AnandKapadia/Mobot_ACE/mobot2.jpg

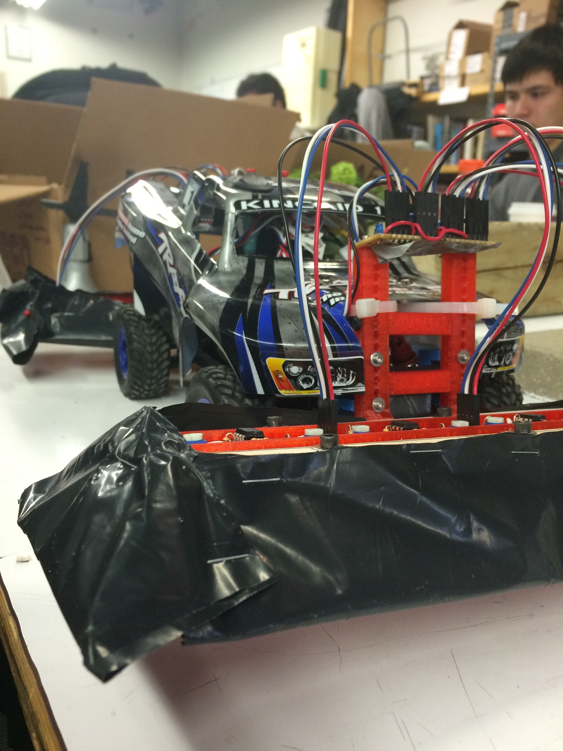
mobot2.jpg
