AnandKapadia/Mobot_ACE/mobot1.jpg

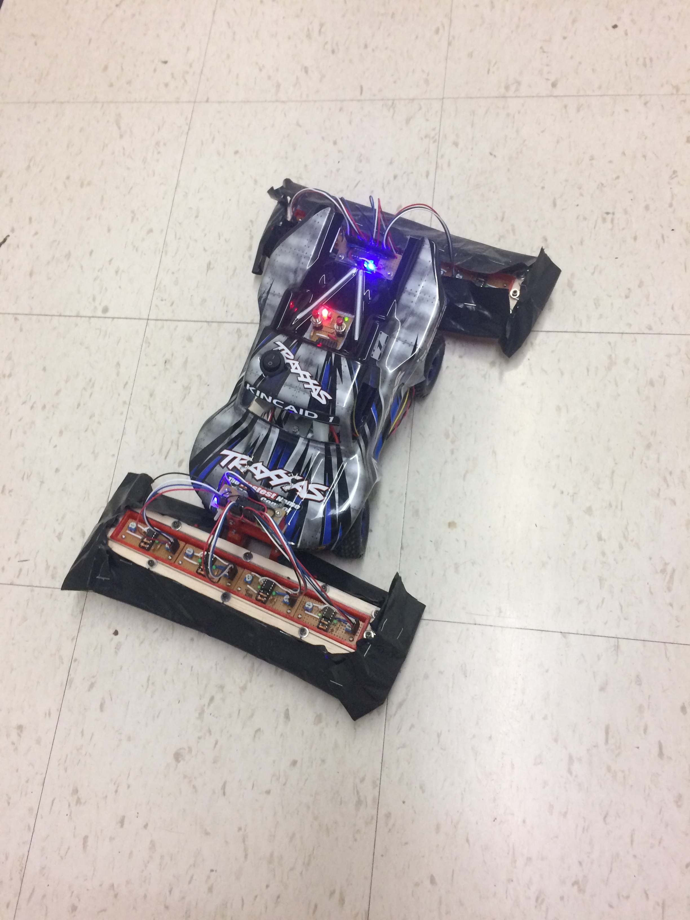
mobot1.jpg
