AnandKapadia/Mobot_ACE/documentation/arduino/mobot_arduinoPins.jpg

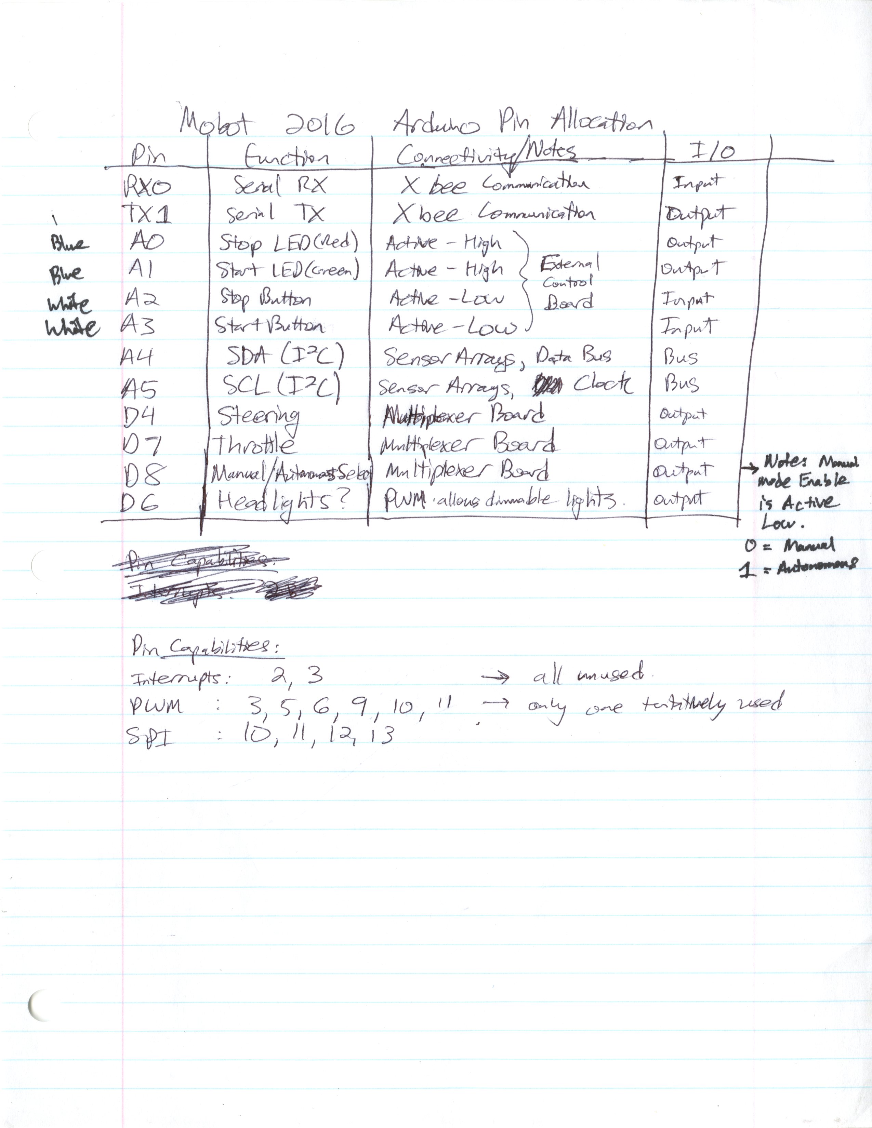
documentation/arduino/mobot_arduinoPins.jpg
