AnandKapadia/Mobot_ACE/documentation/control/mobot_controlPanelLayout.jpg

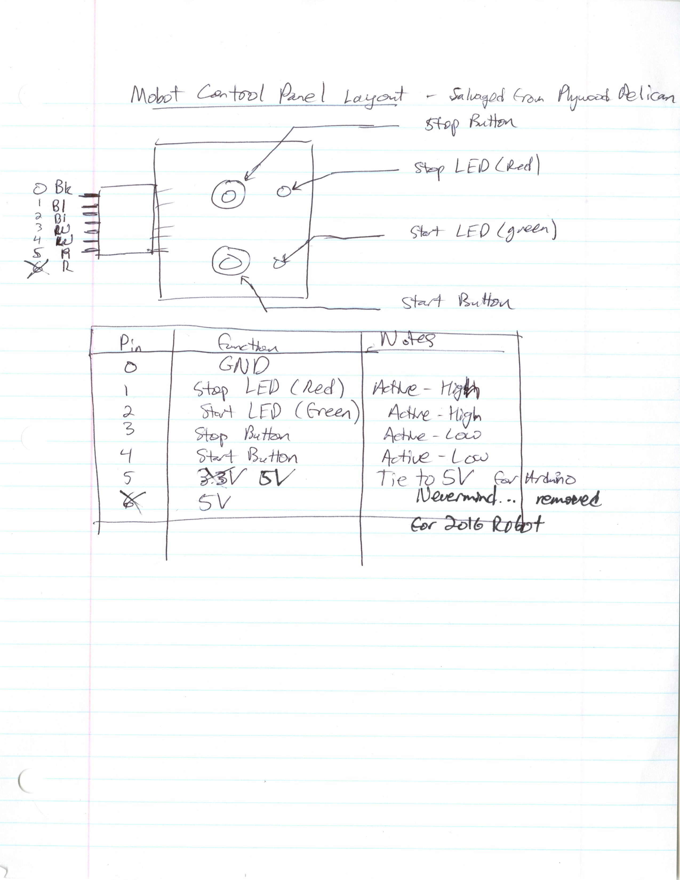
documentation/control/mobot_controlPanelLayout.jpg
