AnandKapadia/Mobot_ACE/documentation/control/mobot_finalControlSystem.jpg

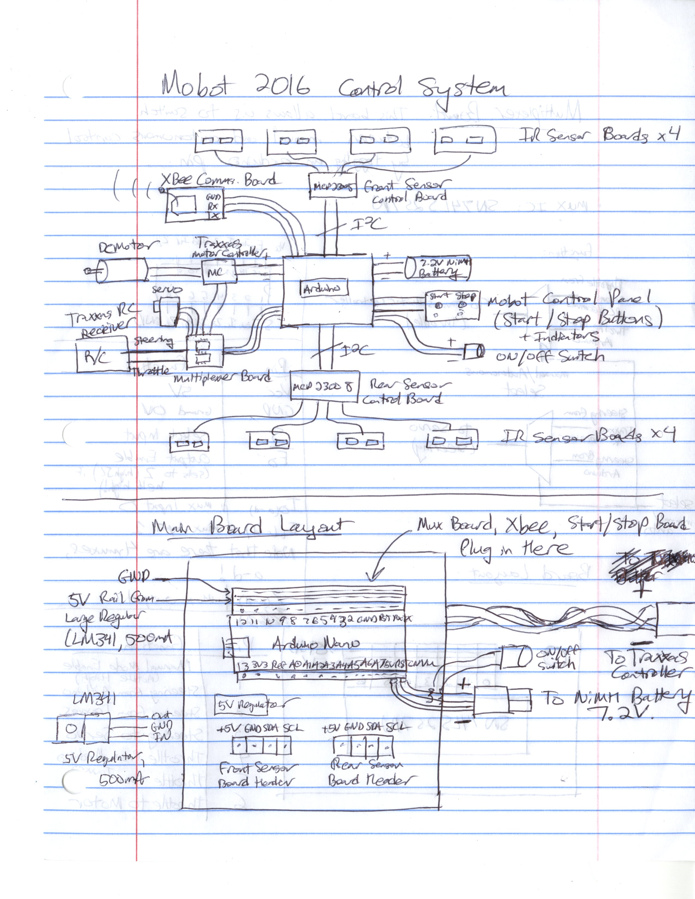
documentation/control/mobot_finalControlSystem.jpg
