AnandKapadia/Mobot_ACE/documentation/control/mobot_multiplexerBoardLayout.jpg

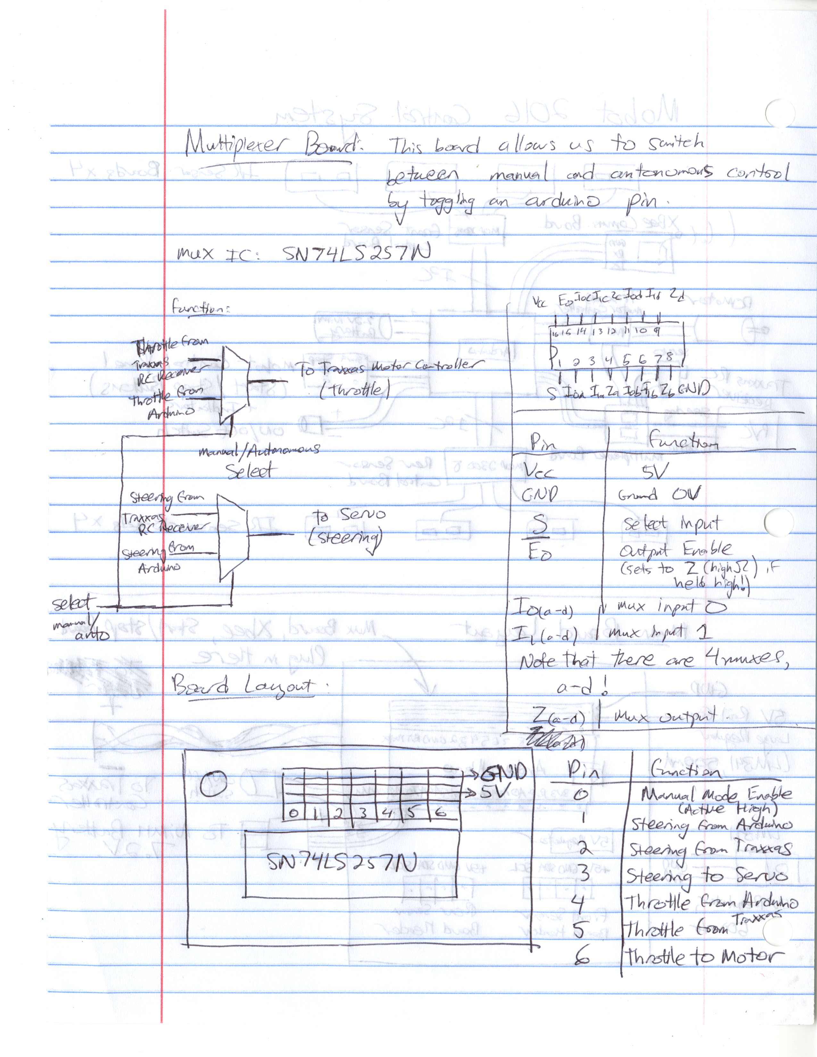
documentation/control/mobot_multiplexerBoardLayout.jpg
