AnandKapadia/Mobot_ACE/documentation/control/mobot_prototypeControlSystem1.jpg

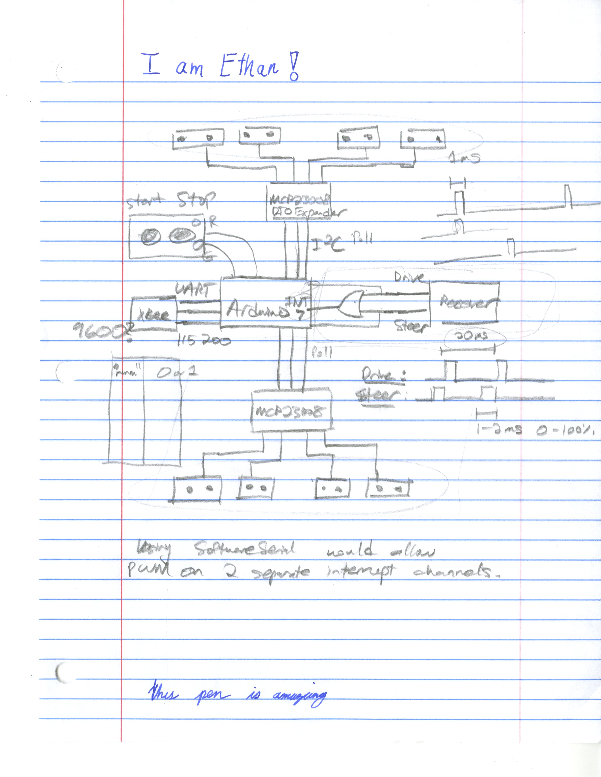
documentation/control/mobot_prototypeControlSystem1.jpg
