AnandKapadia/Mobot_ACE/documentation/control/mobot_prototypeControlSystem2.jpg

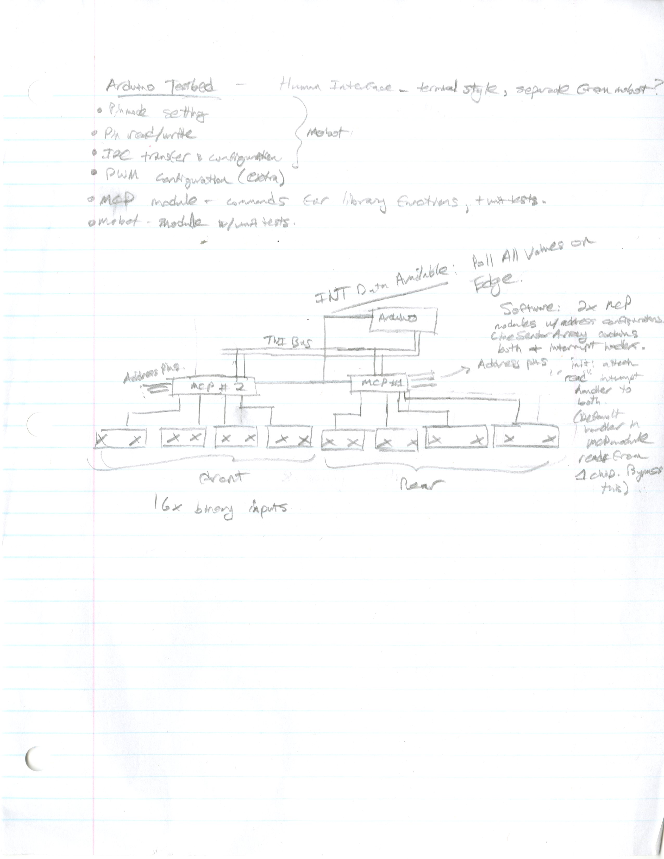
documentation/control/mobot_prototypeControlSystem2.jpg
