AnandKapadia/Mobot_ACE/documentation/control/mobot_rcCarChannels.jpg

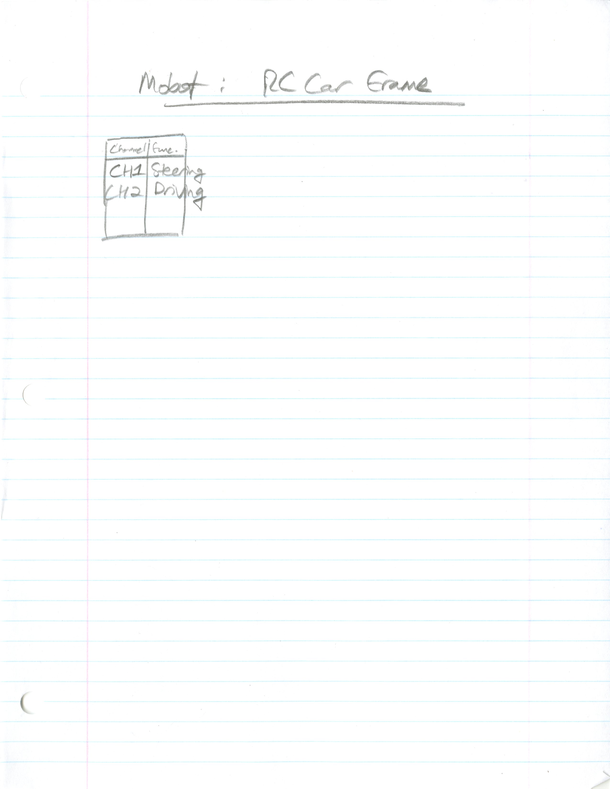
documentation/control/mobot_rcCarChannels.jpg
