AnandKapadia/Mobot_ACE/documentation/planning/mobot_earlyPlanning1.jpg

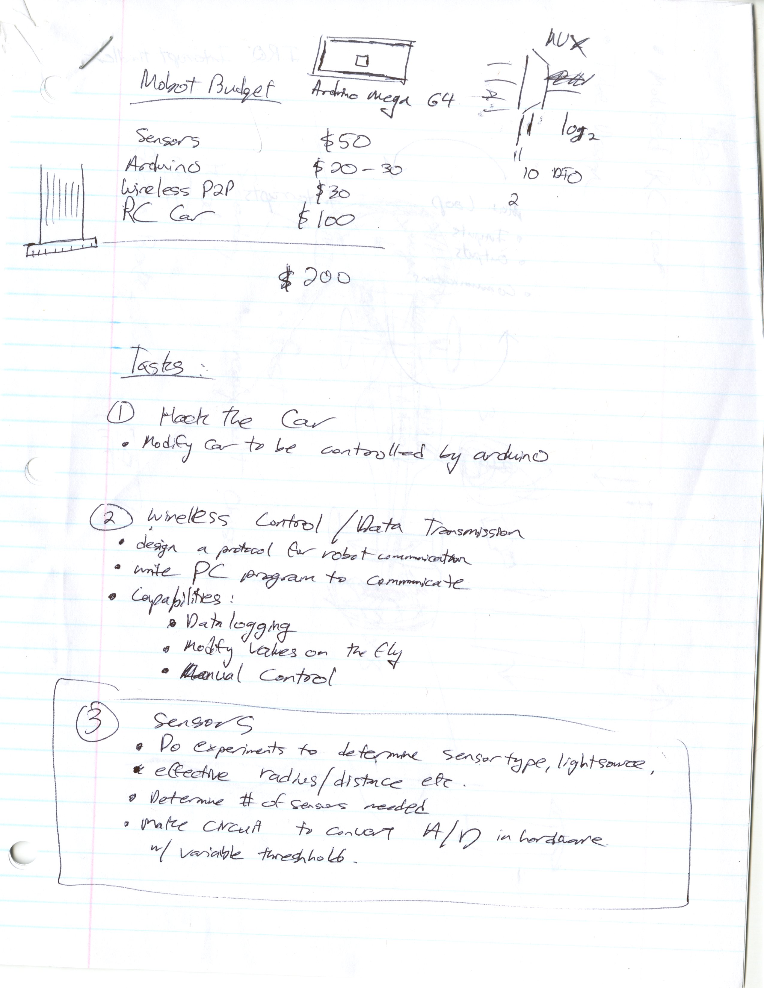
documentation/planning/mobot_earlyPlanning1.jpg
