AnandKapadia/Mobot_ACE/documentation/planning/mobot_earlyPlanning2.jpg

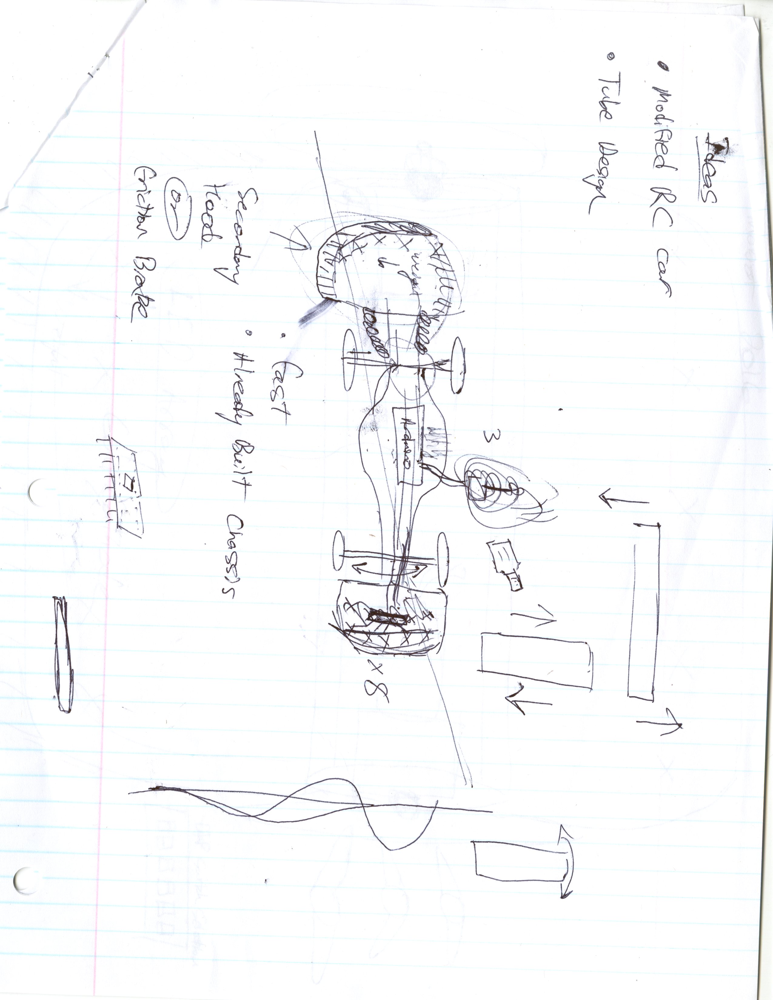
documentation/planning/mobot_earlyPlanning2.jpg
