AnandKapadia/Mobot_ACE/documentation/planning/mobot_earlyPlanning3.jpg

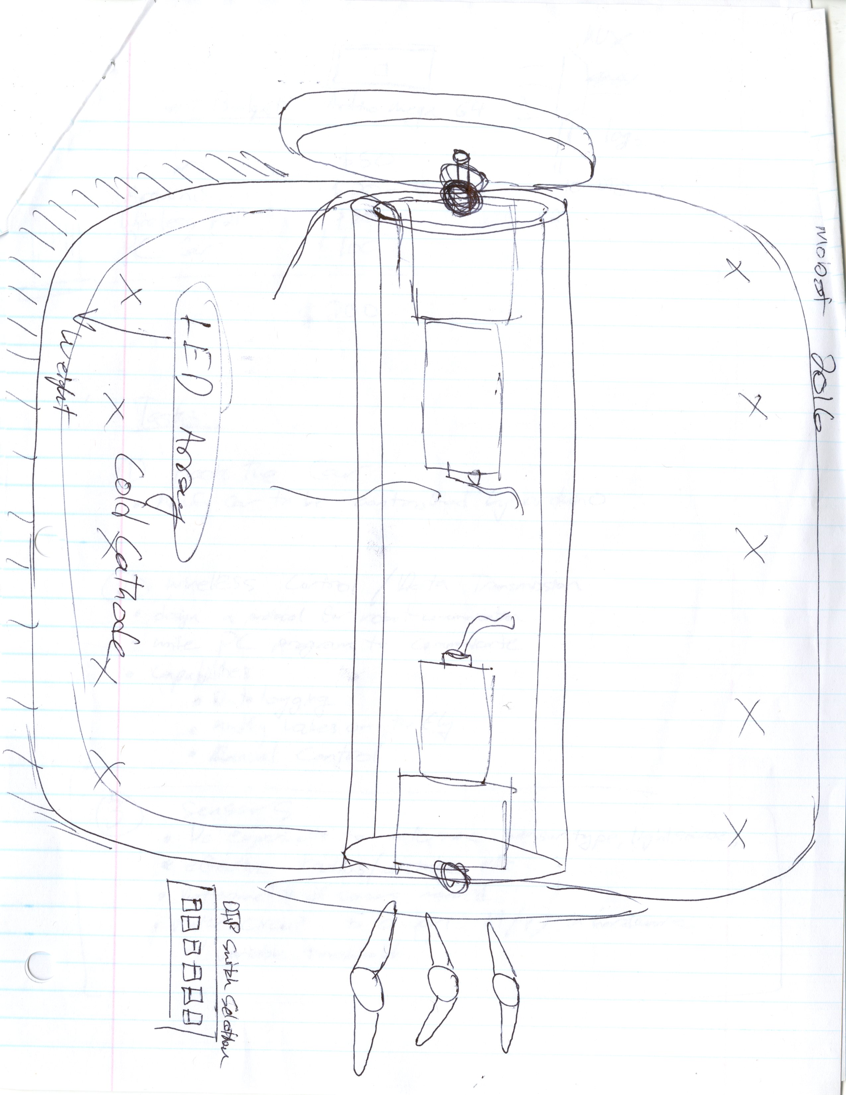
documentation/planning/mobot_earlyPlanning3.jpg
