AnandKapadia/Mobot_ACE/documentation/planning/mobot_implementationDetails.jpg

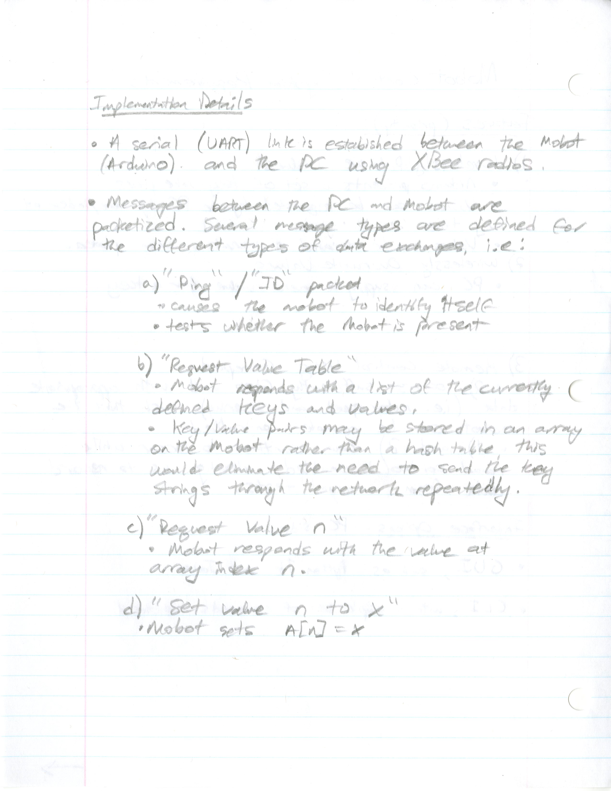
documentation/planning/mobot_implementationDetails.jpg
