AnandKapadia/Mobot_ACE/documentation/planning/mobot_requirements.jpg

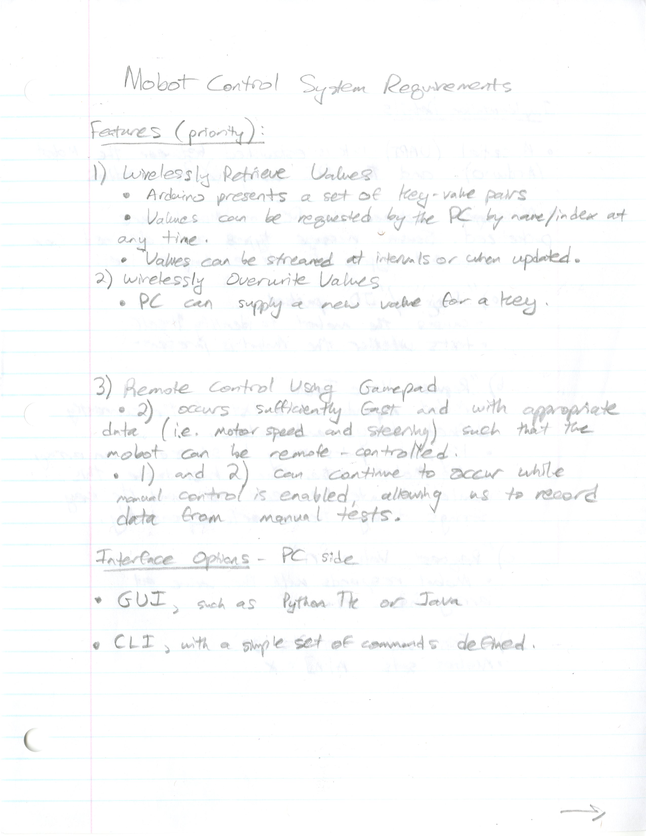
documentation/planning/mobot_requirements.jpg
