AnandKapadia/Mobot_ACE/documentation/sensors/mobot_controllerBoardLayout1.jpg

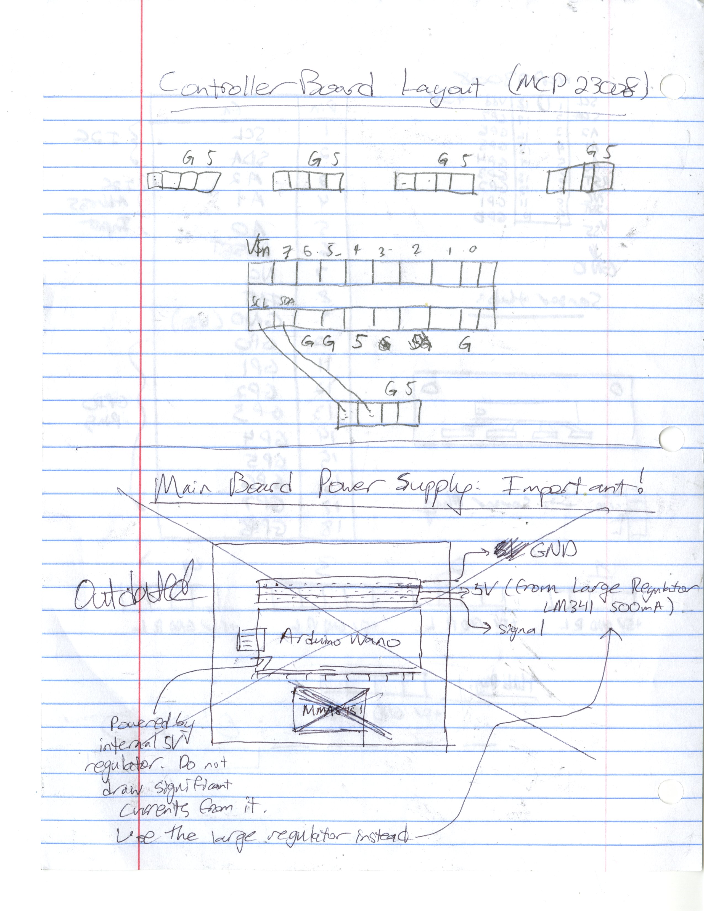
documentation/sensors/mobot_controllerBoardLayout1.jpg
