AnandKapadia/Mobot_ACE/documentation/sensors/mobot_controllerBoardLayout2.jpg

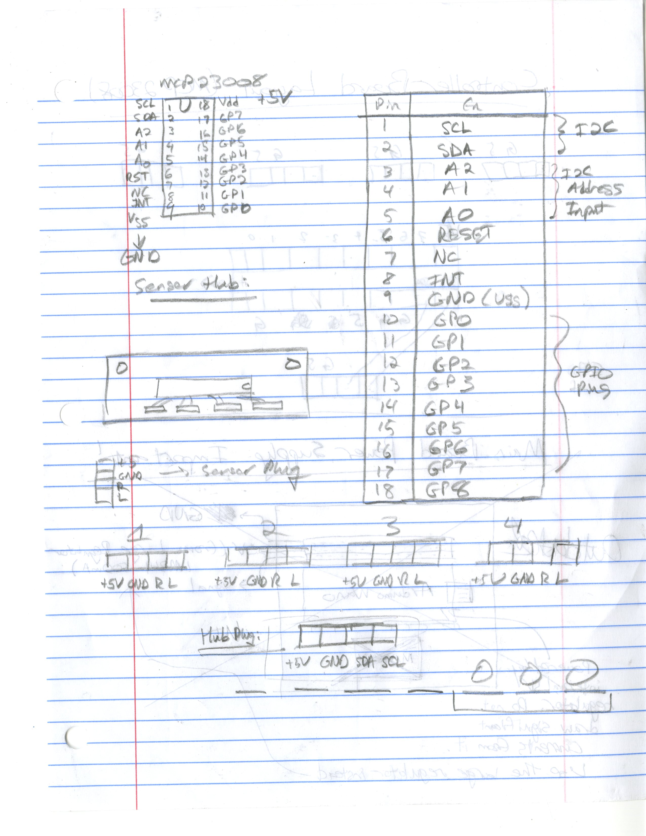
documentation/sensors/mobot_controllerBoardLayout2.jpg
