AnandKapadia/Mobot_ACE/documentation/sensors/mobot_controllerBoardLayout3.jpg

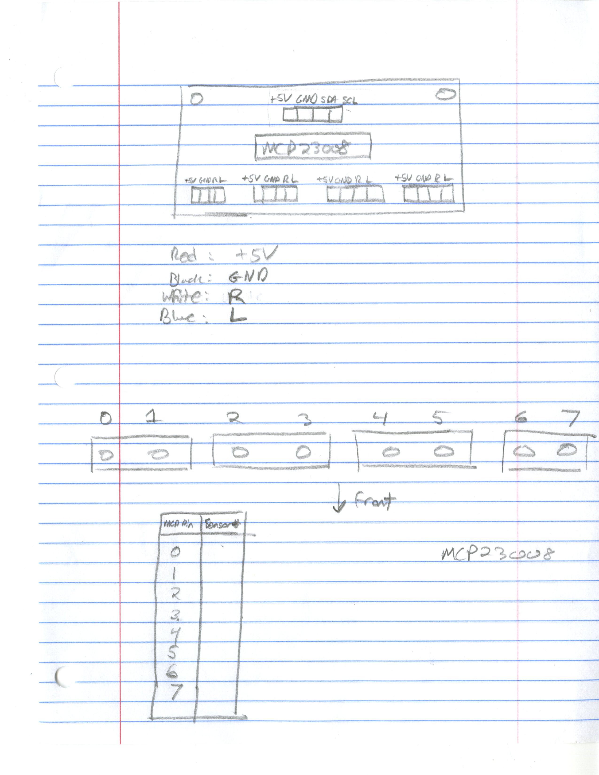
documentation/sensors/mobot_controllerBoardLayout3.jpg
