AnandKapadia/Mobot_ACE/documentation/sensors/mobot_sensorarray.jpg

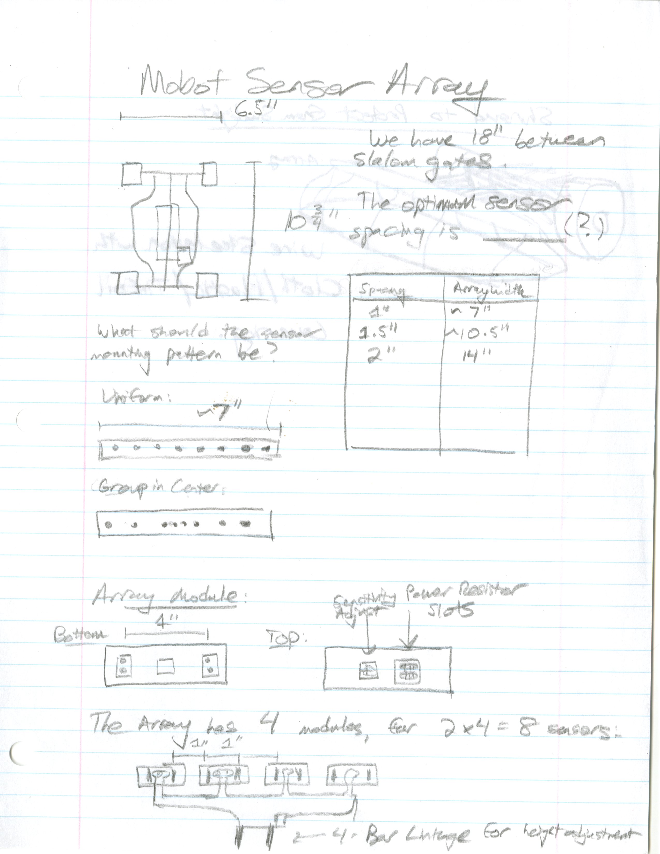
documentation/sensors/mobot_sensorarray.jpg
