AnandKapadia/Mobot_ACE/documentation/sensors/mobot_sensorBoardLayout.jpg

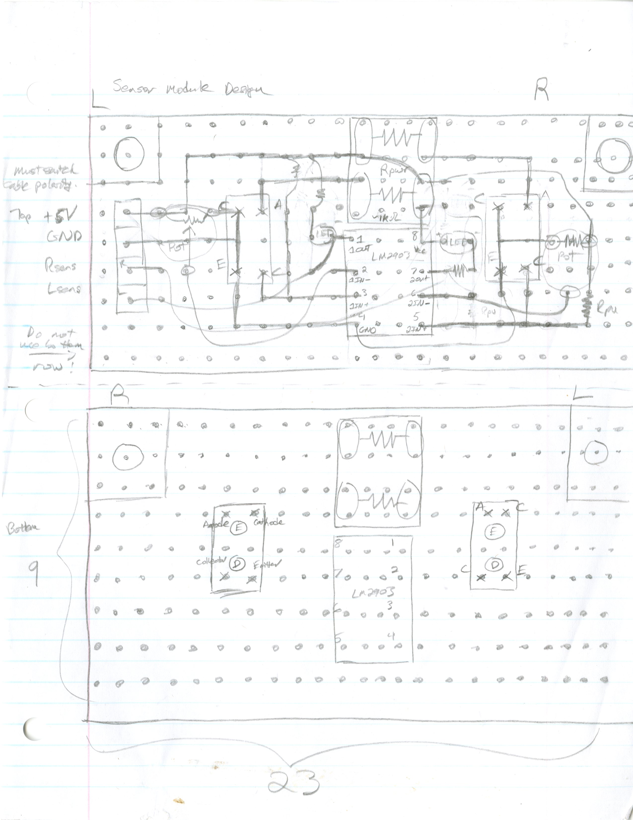
documentation/sensors/mobot_sensorBoardLayout.jpg
