AnandKapadia/Mobot_ACE/documentation/sensors/mobot_sensors1.jpg

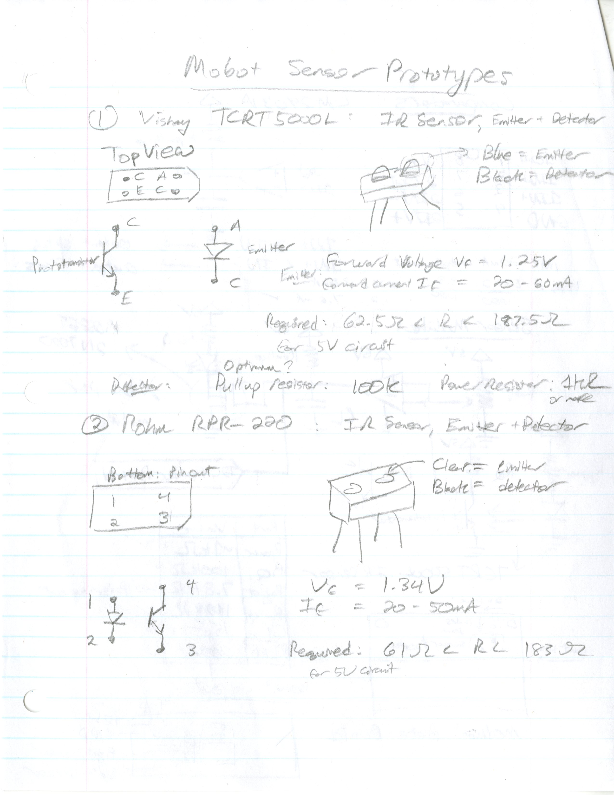
documentation/sensors/mobot_sensors1.jpg
