AnandKapadia/Mobot_ACE/documentation/sensors/mobot_sensors2.jpg

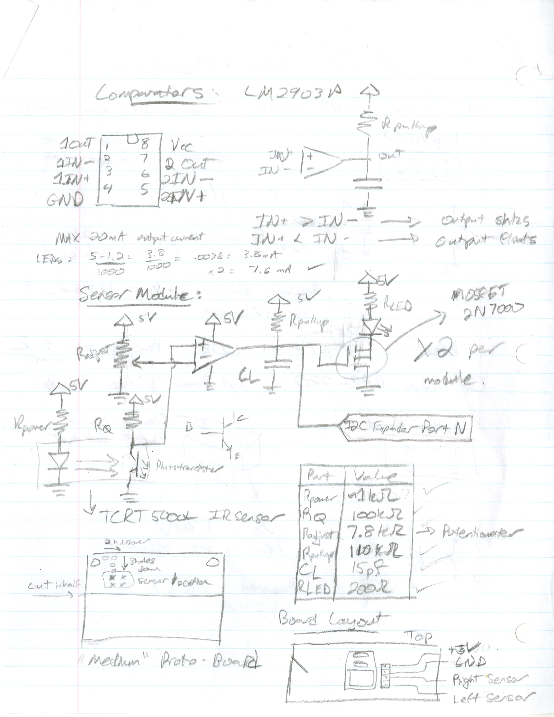
documentation/sensors/mobot_sensors2.jpg
