AnandKapadia/Mobot_ACE/documentation/sensors/mobot_shroud.jpg

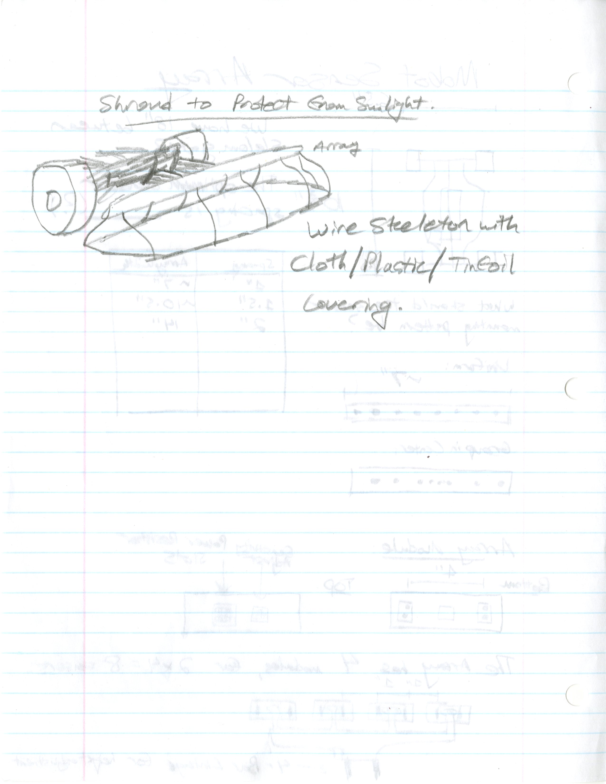
documentation/sensors/mobot_shroud.jpg
