AnandKapadia/Mobot_ACE/documentation/xbee/mobot_xbeeConfig.jpg

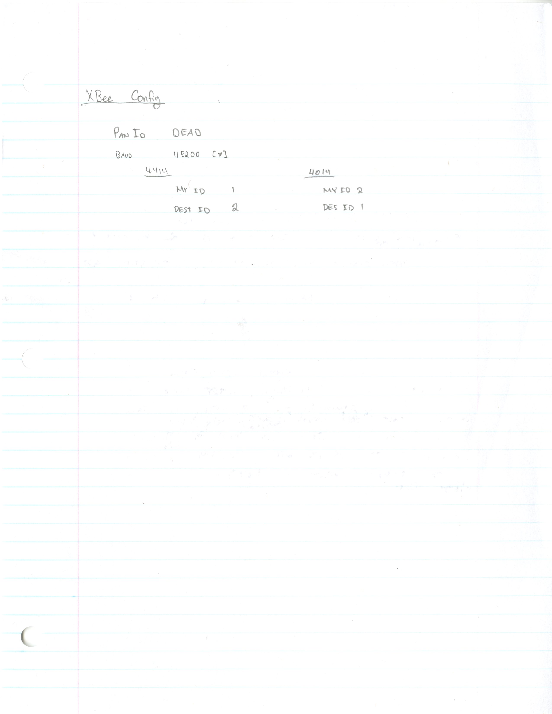
documentation/xbee/mobot_xbeeConfig.jpg
