AnandKapadia/Mobot_ACE/bom.ods

Mobot Bill of Materials (BOM)
Connor Willison
Ethan Tseng
Anand Kapadia
P/N | Desc | Link | Quantity | Unit Price | Subtotal
TCRF5000L | IR Sensor | http://www.digikey.com/scripts/DkSearch/dksus.dll?Detail&itemSeq=183713155&uq=635828644165876851 | 25 | $0.85 | $21.20
Xbee Exp | Xbee Exp | http://www.digikey.com/scripts/DkSearch/dksus.dll?Detail&itemSeq=183713197&uq=635828644165876851 | 1 | $9.95 | $9.95
Xbee USB | Xbee USB | http://www.digikey.com/scripts/DkSearch/dksus.dll?Detail&itemSeq=183713222&uq=635828644165886852 | 1 | $24.95 | $24.95
MCP23008 | I2C Expander | http://www.digikey.com/scripts/DkSearch/dksus.dll?Detail&itemSeq=183713995&uq=635828644165886852 | 4 | $1.02 | $4.08
Digikey | IR Sensor .236” | http://www.digikey.com/product-detail/en/RPR-220/511-1366-ND/638554 | 3 | $1.77 | $5.31
Digikey | IR Sensor .591” | http://www.digikey.com/product-detail/en/TCRT5000L/751-1034-5-ND/1681168 | 3 | $1.26 | $3.78
Sparkfun RF | Xbee 300ft | https://www.sparkfun.com/products/8665 | 2 | $24.95 | $49.90
Traxxas 1/18 | RC Car | http://www.ebay.com/itm/Traxxas-1-18-LaTrax-Teton-4WD-Monster-Truck-RTR-Green-w-2-4GHz-Radio-w-ID-/191666947207 | 1 | $129.95 | $129.95
Traxxas 1/18 | Extra Shocks | http://www.ebay.com/itm/191660591787 | 1 | $13.00 | $13.00
 |  |  |  |  | $262.12
