AnandKapadia/Mobot_ACE/documentation/track/mobot_trackMeasurements1.jpg

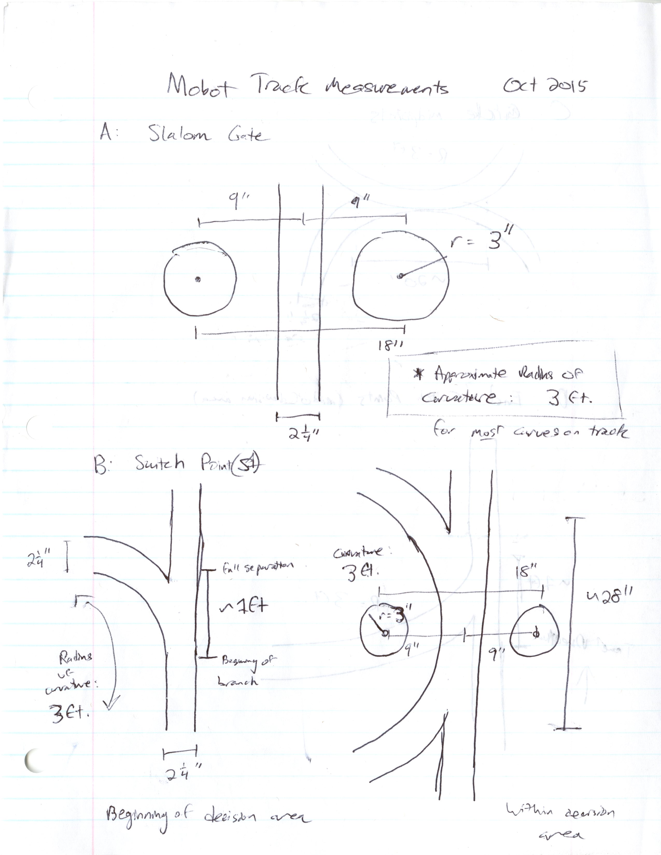
documentation/track/mobot_trackMeasurements1.jpg
