AnandKapadia/Mobot_ACE/documentation/track/mobot_trackMeasurements2.jpg

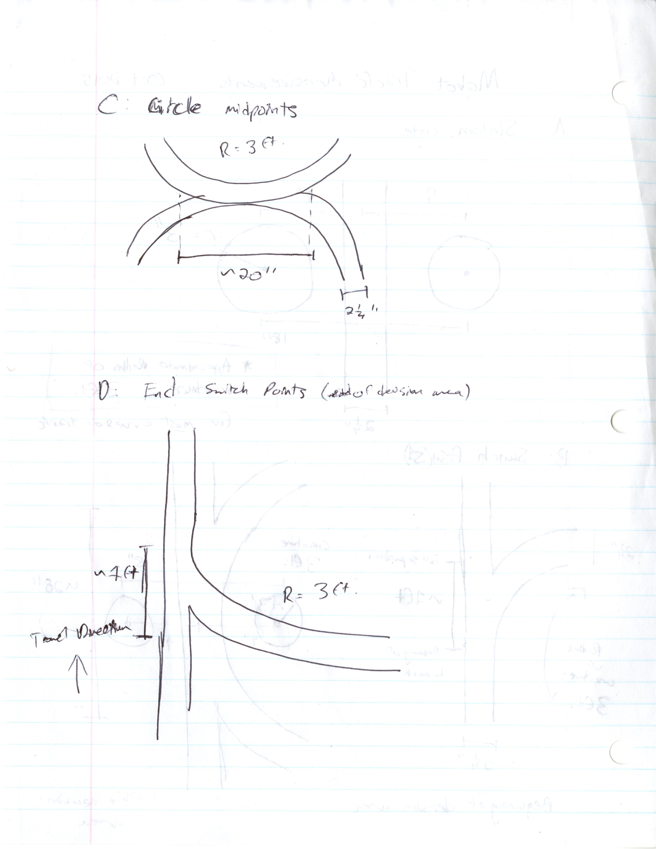
documentation/track/mobot_trackMeasurements2.jpg
