AnandKapadia/Mobot_ACE/(commit log)

2015-11-12 Added bill of materials.
    Updated readme.
    [bom.ods]
2015-11-27 Added spare shocks to bom.
    [bom.ods]
2015-12-29 Added Arduino Code to Communicate to Xbee
2016-03-14 Added scans of handwritten documenation. Most important one is the arduino pin allocation.
2016-04-02 First push of main code
    This code communicates XBee and reads sensor data properly
2016-04-03 Added start, stop, motor control
2016-04-03 Steering and Throttle ready
2016-04-09 start and stop led signals fixed
    [mobot_main.ino]
2016-04-09 throttle now changeable by packets
2016-04-14 Changing steering algorithm
2016-04-14 Removed prints
